JacobZhao/Solar-cell-detection-system/README.md

# Solar-cell-detection-system
Detect solar cell`s Short-circuit current, Open circuit voltage and Temperature
