JacobZhao/Solar-cell-detection-system/(list of files, cad)

Other CAD files:
PCB1.DWG
