JacobZhao/Solar-cell-detection-system/(list of files, drawings)

Other design files:
15F2K60S2.SchLib
AS0512S-1W.SchLib
relay.SchLib
Sheet3.SchDoc
